semlanik/eScooterControl/eScooterNextGen.png

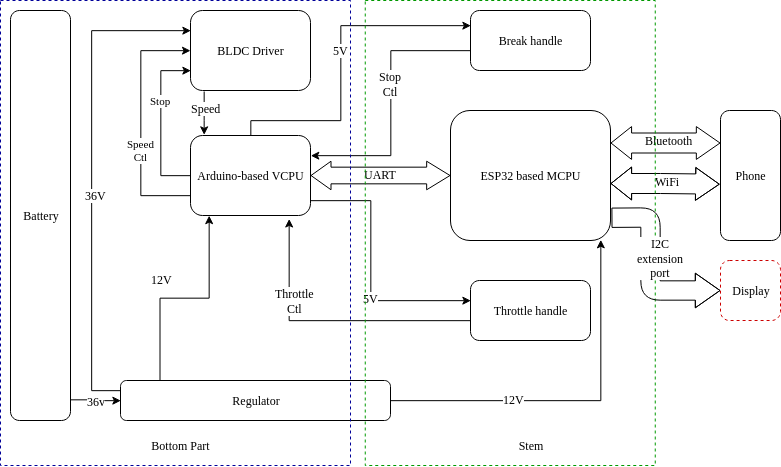
eScooterNextGen.png
