semlanik/eScooterControl/schematic/regulator_schematic.pdf

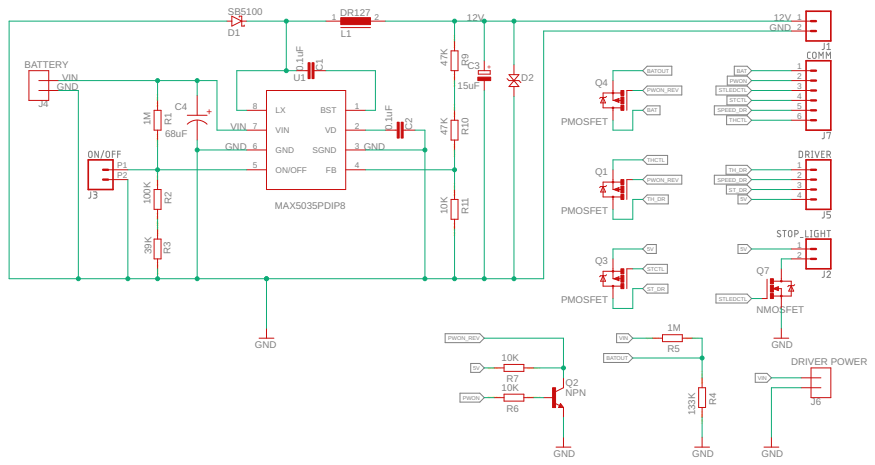
[picture p2: page 1]

SpiceOrder 1 SpiceOrder 2 SpiceOrder 1 SpiceOrder 2 SpiceOrder 1 SpiceOrder 2 SpiceOrder 1 SpiceOrder 2 SpiceOrder 1 SpiceOrder 2 SpiceOrder 1 SpiceOrder 2 SpiceOrder 1 SpiceOrder 2 SpiceOrder 1 SpiceOrder 2 SpiceOrder 1 SpiceOrder 2 SpiceOrder 2 SpiceOrder 1 0.1uF SB5100 DR127 0.1uF 15uF 1M 100K 39K GND 68uF MAX5035PDIP8 BATTERY DRIVER POWER 47K 47K 10K PMOSFET PMOSFET NMOSFET NPN 10K 10K PMOSFET GND GND GND 133K 1M GND C1 D1 1 2 L1 C2 C3 R1 R2 R3 P1P2 121234 D2 C4 BST 1 VD 2 SGND 3 FB 4 ON/OFF 5 GND 6 VIN 7 LX 8 U1 J4 J6 R9 R10 R11 12123456 Q1 Q3 Q7 Q2 R6 R7 Q4 R4 R5 12V 12V THCTL THCTL ST_DR ST_DR 5V 5V 5V 5V STLEDCTL STLEDCTL PWON PWON BAT BAT STCTL STCTL VIN VIN VIN VIN GND GND GND GND BATOUT BATOUT SPEED_DR SPEED_DR TH_DR TH_DR PWON_REV PWON_REV PWON_REV + +
