semlanik/eScooterControl/schematic/ECU_schematic.pdf

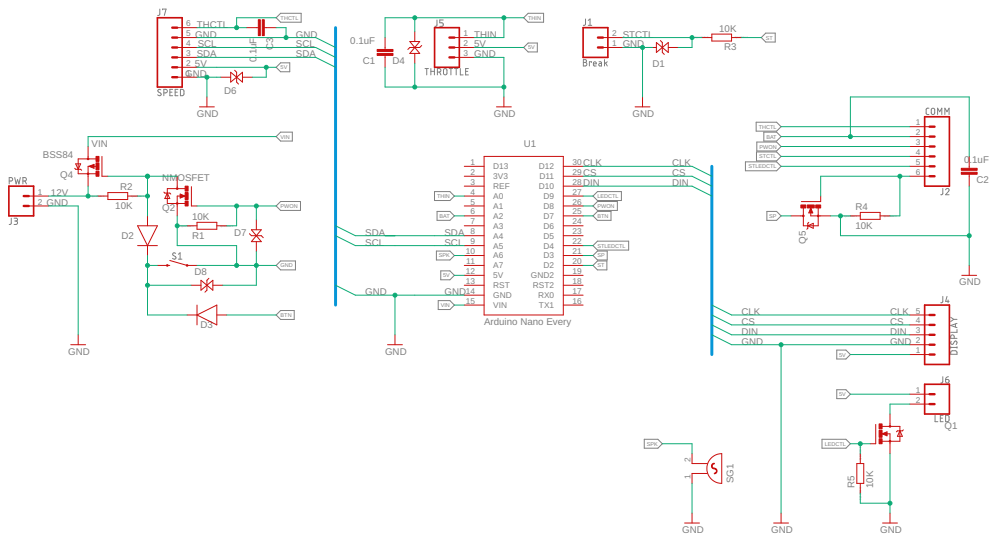
[picture p3: page 1]
