semlanik/eScooterControl/schematic/regulator.brd

## EAGLE design schematic/regulator.brd (2020-10-26)

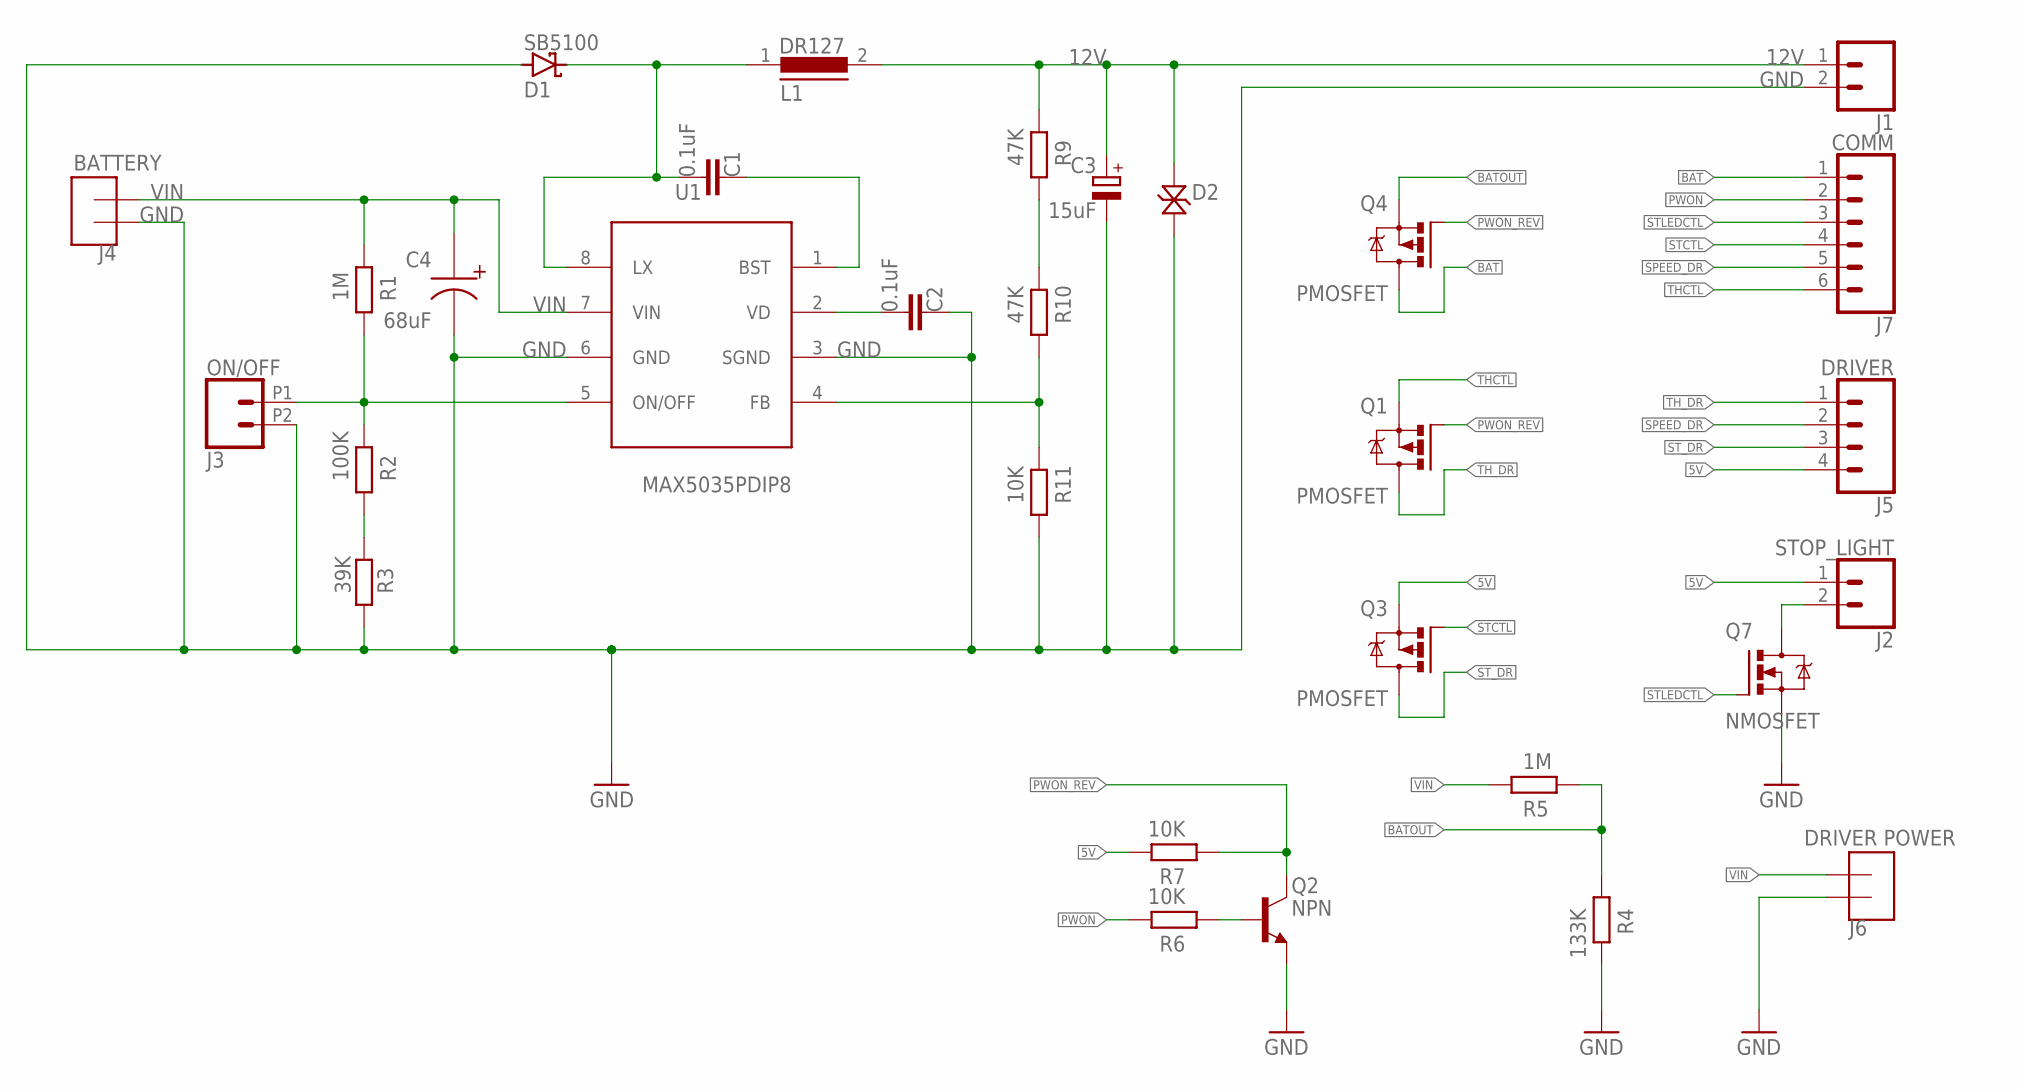
[picture p4: schematic regulator.sch]

Parts:
C1, C2: 0.1uF; CAPC3216X135
C3: 15uF; CAPMP7343X310N
C4: 68uF; CAPAE1230X1250N
D1: SB5100; DO201AD
D2: P4SMAJ12CA; DIOM5027X220N
J1: CONN_02PTH3; 1X02_LONGPADS
J2: STOP_LIGHT; 1X02
J3: ON/OFF; 1X02_2.54_SCREWTERM
J4: BATTERY; XT60
J5: DRIVER; 1X04
J6: DRIVER POWER; XT60
J7: COMM; 1X06_LONGPADS
L1: DR127
Q1, Q3, Q4: PMOSFET; SOT23
Q2: NPN; SOT95P237X112-3N
Q7: NMOSFET; SOT23
R1, R5: 1M; R1206
R2: 100K; R1206
R3: 39K; R1206
R4: 133K; R1206
R6, R7, R11: 10K; R1206
R9, R10: 47K; R1206
U1: MAX5035PDIP8; DIP826W56P254L937H458Q8B

Connections:
5V: J2.1, J5.4, Q3.2 (S), R7.1
12V: C3.1 (+), D2.1, J1.1, L1.2, R9.1
BAT: J7.1, Q4.3 (D)
BATOUT: Q4.2 (S), R4.2, R5.1
GND: C2.1, C3.2 (-), C4.2, D1.A, D2.2, J1.2, J3.P2 (2), J4.GND, J6.GND, Q2.1 (E), Q7.2 (S), R3.1, R4.1, R11.2, U1.3 (SGND), U1.6 (GND)
unnamed: C1.1, U1.1 (BST)
unnamed: C1.2, D1.C, L1.1, U1.8 (LX)
unnamed: Q2.2 (B), R6.2
unnamed: C2.2, U1.2 (VD)
unnamed: J3.P1 (1), R1.2, R2.1, U1.5 (ON/OFF)
unnamed: R9.2, R10.1
unnamed: R2.2, R3.2
unnamed: R10.2, R11.1, U1.4 (FB)
PWON: J7.2, R6.1
PWON_REV: Q1.1 (G), Q2.3 (C), Q4.1 (G), R7.2
SPEED_DR: J5.2, J7.5
STCTL: J7.4, Q3.1 (G)
STLEDCTL: J7.3, Q7.1 (G)
STLEDOUT: J2.2, Q7.3 (D)
ST_DR: J5.3, Q3.3 (D)
THCTL: J7.6, Q1.2 (S)
TH_DR: J5.1, Q1.3 (D)
VIN: C4.1, J4.VCC, J6.VCC, R1.1, R5.2, U1.7 (VIN)

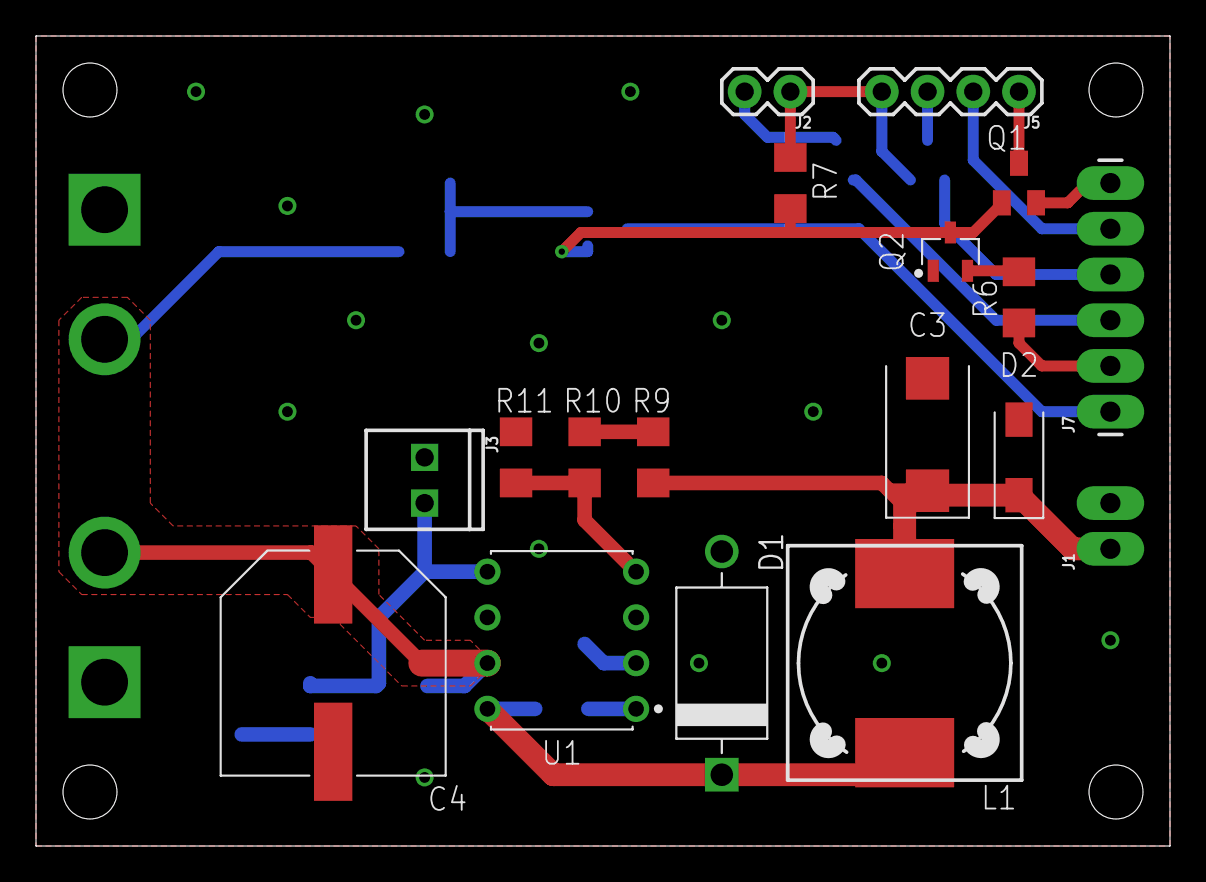
[picture p5: board regulator.brd from above]

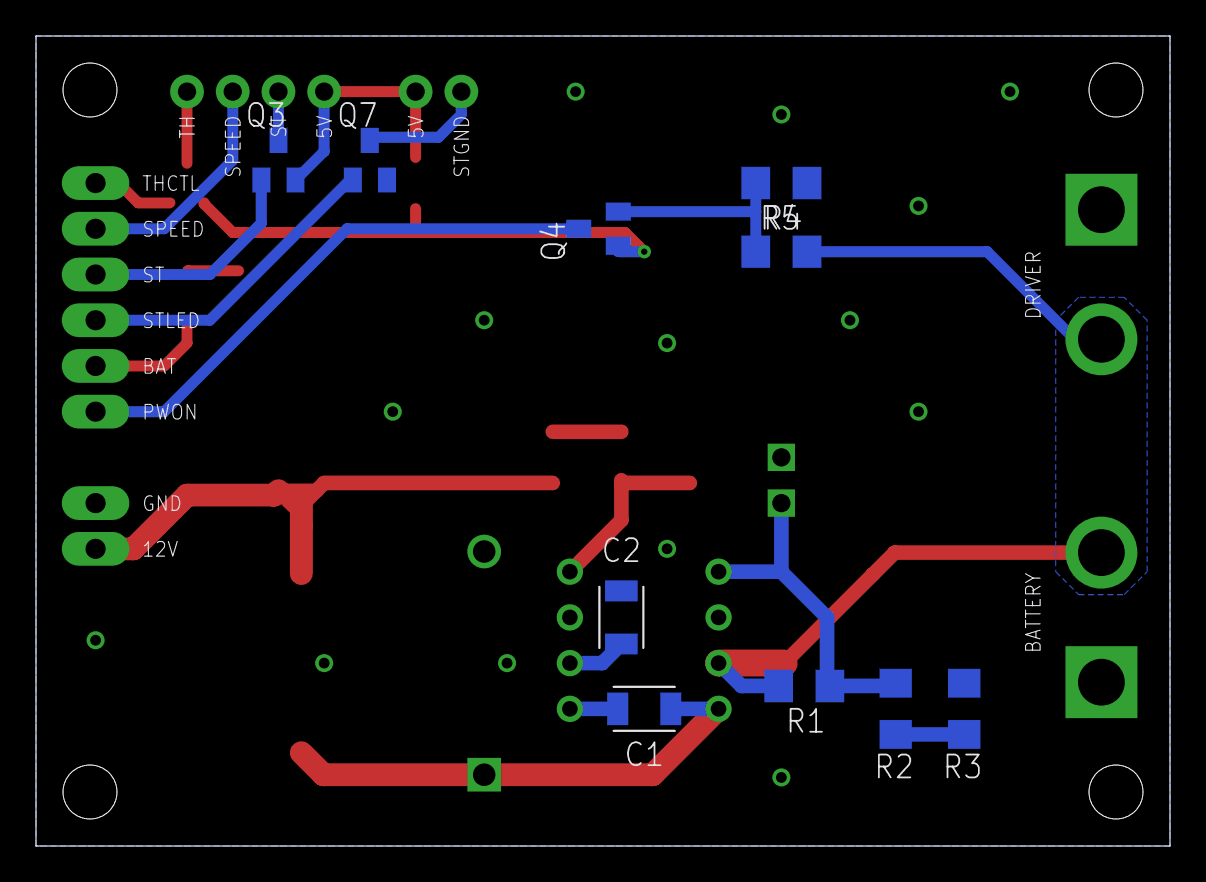
[picture p6: board regulator.brd from below]

Board: 2 copper layers, 63.0 x 45.0 mm, 30 parts (10 on the bottom side), 23 nets.
