semlanik/eScooterControl/schematic/ECU.brd

## EAGLE design schematic/ECU.brd (2020-10-22)

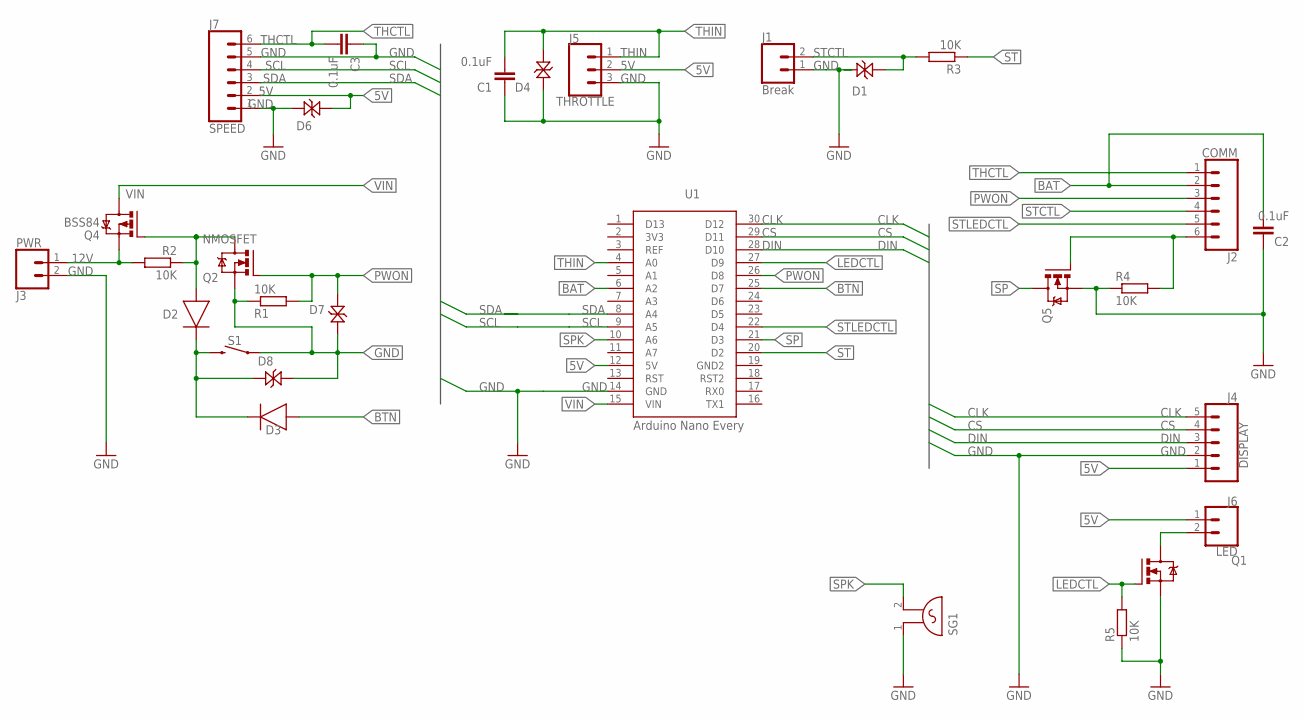
[picture p7: schematic ECU.sch]

Parts:
C1, C2, C3: 0.1uF; CAPC3216X135
D1, D4, D6, D7, D8: TVS_DIODESMA; DIOM5027X220N
D2, D3: DIODE_DO-215-AC; SOD6126X290
J1: Break; 1X02
J2: COMM; 1X06
J3: PWR; 1X02
J4: DISPLAY; 1X05
J5: THROTTLE; 1X03
J6: LED; 1X02
J7: SPEED; 1X06
Q1, Q2, Q5: NMOSFET; SOT23
Q4: BSS84; SOT23
R1, R2, R3, R4, R5: 10K; R1206
S1: MOMENTARY-SWITCH-SPST-PTH-6.0MM; TACTILE_SWITCH_PTH_6.0MM
SG1: F/HGP
U1: Arduino Nano Every; SON254P1750X4300X120-30M

Connections:
3V3: U1.2 (3V3)
5V: D6.1, J4.1, J5.2, J6.1, J7.2, U1.12 (5V)
12V: J3.1, Q4.2 (S), R2.2
BAT: C2.1, J2.2, U1.6 (A2)
BTN: D3.2 (A), U1.25 (D7)
CLK: J4.5, U1.30 (D12)
CS: J4.4, U1.29 (D11)
DIN: J4.3, U1.28 (D10)
GND: C1.1, C2.2, C3.2, D1.1, D4.1, D6.2, D7.2, D8.1, J1.1, J3.2, J4.2, J5.3, J7.1, J7.5, Q1.2 (S), Q2.2 (S), Q5.2 (S), R1.1, R4.1, R5.1, S1.1, S1.2 (1), SG1.1, U1.14 (GND)
GND2: U1.19 (GND2)
LEDCTL: Q1.1 (G), R5.2, U1.27 (D9)
unnamed: J6.2, Q1.3 (D)
unnamed: D2.2 (A), Q2.3 (D), Q4.1 (G), R2.1
unnamed: D2.1 (C), D3.1 (C), D8.2, S1.3 (2), S1.4 (2)
PWON: D7.1, J2.3, Q2.1 (G), R1.2, U1.26 (D8)
SCL: J7.4, U1.9 (A5)
SDA: J7.3, U1.8 (A4)
SP: Q5.3 (D), U1.21 (D3)
SPEED: J2.6, Q5.1 (G), R4.2
SPK: SG1.2, U1.10 (A6)
ST: R3.1, U1.20 (D2)
STCTL: D1.2, J1.2, J2.4, R3.2
STLEDCTL: J2.5, U1.22 (D4)
THCTL: C3.1, J2.1, J7.6
THIN: C1.2, D4.2, J5.1, U1.4 (A0)
VIN: Q4.3 (D), U1.15 (VIN)

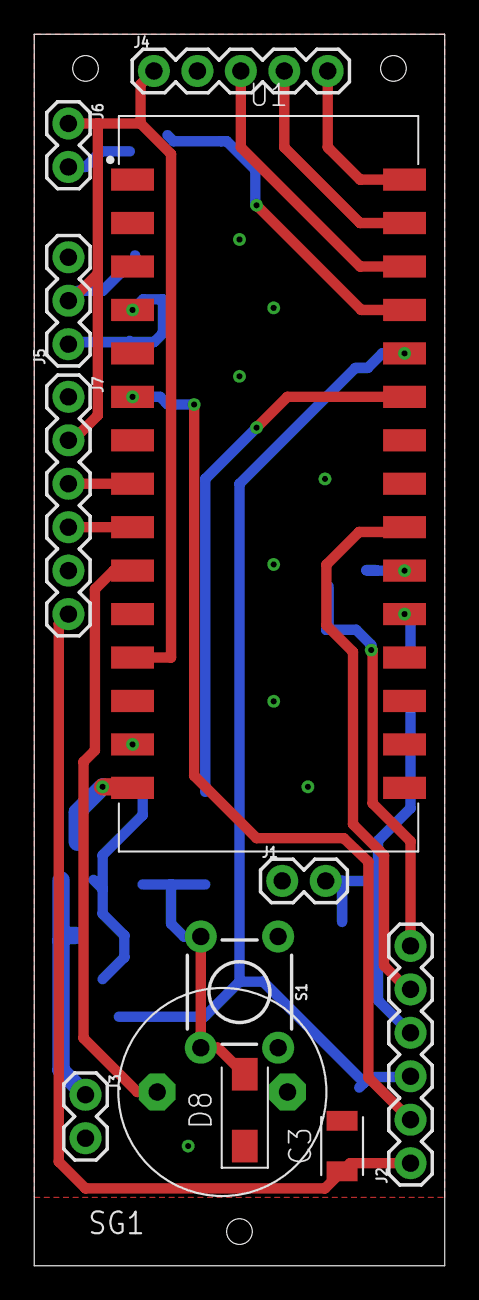
[picture p8: board ECU.brd from above]

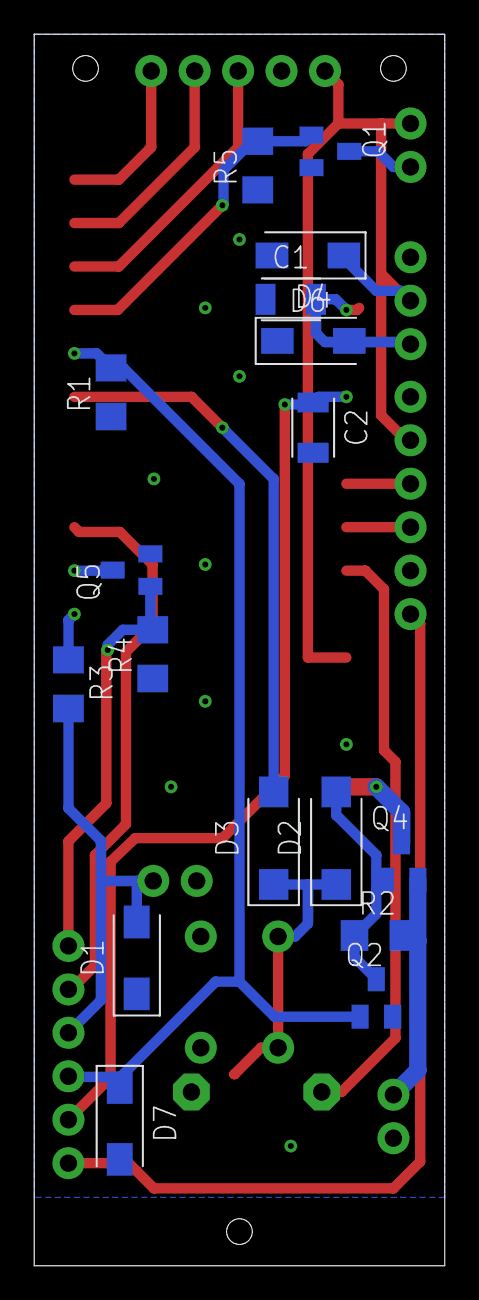
[picture p9: board ECU.brd from below]

Board: 2 copper layers, 24.0 x 72.0 mm, 29 parts (17 on the bottom side), 24 nets.
