semlanik/eScooterControl/(threads)

Thread 1 (2020-10-18):

Знаки общих проводов и линий питания

vxm9, 2020-10-18:
Глянул ECU_schematic
Настоятельно рекомендую убрать со схемы путаницу из проводников питания, особенно GND. C 5V же получилось. При трассировке программа все равно потребует соединить, а на схеме они только мешаются.
https://cxem.net/beginner/beginner134.php
Даже если просто убрать со схемы земляные провода - она уже будет проще читаться.
Кроме того, для того, чтобы схему было логичнее читать - ее делают слева направо и сверху вниз, похоже на нотацию IDEF0.
Слева - вход всяких напряжений питания, справа - выход.
Сверху - вход управляющих воздействий, кнопок, потенциометров. Снизу - управляемые устройства (например, в вашем случае - дисплей).

semlanik, 2020-10-20:
Приветсвую, спасибо за комментарии. Я немного переделал схематику, после первых тестов. Попробую привести в порядок. В целом если будет желание/время будет круто если будут предложения по функциональной части схематик. Спасибо!
