semlanik/eScooterControl/Arduino/eScooterControl/eScooterControl.ino

/*
 * MIT License
 *
 * Copyright (c) 2020 Alexey Edelev <semlanik@gmail.com>
 *
 * This file is part of eScooterControl project https://github.com/semlanik/eScooterControl
 *
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
 * THE SOFTWARE IS PROVIDED "AS IS", WITHOUT WARRANTY OF ANY KIND, EXPRESS OR IMPLIED,
 * INCLUDING BUT NOT LIMITED TO THE WARRANTIES OF MERCHANTABILITY, FITNESS FOR A PARTICULAR
 * PURPOSE AND NONINFRINGEMENT. IN NO EVENT SHALL THE AUTHORS OR COPYRIGHT HOLDERS BE LIABLE
 * FOR ANY CLAIM, DAMAGES OR OTHER LIABILITY, WHETHER IN AN ACTION OF CONTRACT, TORT OR
 * OTHERWISE, ARISING FROM, OUT OF OR IN CONNECTION WITH THE SOFTWARE OR THE USE OR OTHER
 * DEALINGS IN THE SOFTWARE.
 */
#include "thread.h"
#include "display.h"
#include "speedometer.h"
#include "accelerationcontrol.h"
#include "buttoncontrol.h"
#include "battery.h"

const unsigned long AcceleratorPedalUpdateTime = 200;
const unsigned long AcceleratorUpdateTime = 10;
const unsigned long DisplayUpdateTime = 250;
const unsigned long BatteryUpdateTime = 1000;
const unsigned long ButtonHandlingTime = 50;

Thread gDisplayThread = Thread(DisplayUpdateTime);
Thread gBatteryThread = Thread(BatteryUpdateTime);
Thread gAcceleratorPedalThread = Thread(AcceleratorPedalUpdateTime);
Thread gAcceleratorThread = Thread(AcceleratorUpdateTime);
Thread gButtonThread = Thread(ButtonHandlingTime);

unsigned char fakeBatteryLevel = 0;

void setup() {
//  Serial.begin(115200);
//  Serial.println("Init");

  ButtonControl::instance();
  gButtonThread.assignCallback([](){
    ButtonControl::instance()->dispatch();
  });

  delay(500);
  Display::instance();
  gDisplayThread.assignCallback([](){
    Display::instance()->updateDisplayBuffer();
  });

  delay(1000);
  AccelerationControl::instance();
  gAcceleratorPedalThread.assignCallback([](){
    AccelerationControl::instance()->dispatch();
  });

  gAcceleratorThread.assignCallback([](){
    AccelerationControl::instance()->dispatchAcceleration();
  });

  delay(500);
  Speedometer::instance();

  gBatteryThread.assignCallback([](){
    BatterySensor::instance()->dispatch();
  });

  digitalWrite(PowerPin, HIGH); //Initialization end

//  Serial.println("Init complete");
}

void loop() {
  Thread::dispatch();
}
