semlanik/eScooterControl/Arduino/eScooterControl/accelerationcontrol.cpp

/*
 * MIT License
 *
 * Copyright (c) 2020 Alexey Edelev <semlanik@gmail.com>
 *
 * This file is part of eScooterControl project https://github.com/semlanik/eScooterControl
 *
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
 * THE SOFTWARE IS PROVIDED "AS IS", WITHOUT WARRANTY OF ANY KIND, EXPRESS OR IMPLIED,
 * INCLUDING BUT NOT LIMITED TO THE WARRANTIES OF MERCHANTABILITY, FITNESS FOR A PARTICULAR
 * PURPOSE AND NONINFRINGEMENT. IN NO EVENT SHALL THE AUTHORS OR COPYRIGHT HOLDERS BE LIABLE
 * FOR ANY CLAIM, DAMAGES OR OTHER LIABILITY, WHETHER IN AN ACTION OF CONTRACT, TORT OR
 * OTHERWISE, ARISING FROM, OUT OF OR IN CONNECTION WITH THE SOFTWARE OR THE USE OR OTHER
 * DEALINGS IN THE SOFTWARE.
 */
#include "singleton.h"
#include "accelerationcontrol.h"
#include "pinconfig.h"
#include "Wire.h"
#include "display.h"

#include <avr/pgmspace.h>

const int AcceleratorSensorStep = 10;
const int AcceleratorStep = 21;//From 0 to 4095 for 2s with update each 10ms
const int MaxLevel = 10;

const PROGMEM unsigned short AccelerationLevelTable[11] = {
  0,
  410,
  820,
  1230,
  1640,
  2050,
  2460,
  2870,
  3280,
  3690,
  4095
};


AccelerationControl::AccelerationControl() : m_stopState(LOW)
  , m_acceleratorMinValue(0)
  , m_accelerationLevel(0)
  , m_expectedAcceleration(0)
  , m_actualAcceleration(0)
  , m_cruiseTime(0)
  , m_cruiseLevel(0)
{
  Wire.begin();
  pinMode(AcceleratorSensorPin, INPUT);
  pinMode(StopSensorPin, INPUT_PULLUP);
  attachInterrupt(digitalPinToInterrupt(StopSensorPin), []() {
    AccelerationControl::instance()->stop();
  }, CHANGE);

  m_stopState = digitalRead(StopSensorPin);
  m_acceleratorMinValue = analogRead(AcceleratorSensorPin);
}


void AccelerationControl::setAccelerationLevel(const byte level)
{
  if (level == m_accelerationLevel) {
    if (m_cruiseLevel < m_accelerationLevel
          && m_cruiseTime < millis()) {
      m_cruiseLevel = m_accelerationLevel;
    }
    return;
  }

  if (level > m_accelerationLevel) {
    m_cruiseLevel = 0; //Reset cruise whenever accelerator level raised, when drop it means we go down
    m_cruiseTime = millis() + CruiseTime;  
  }

  m_accelerationLevel = level;
}

void AccelerationControl::dispatch()
{  
  if (m_stopState == LOW) {
    setAccelerationLevel(readAcceleratorData());
  }
  updateAcceleration();
}

void AccelerationControl::stop() {
  m_stopState = digitalRead(StopSensorPin);
  Display::instance()->setStop(m_stopState == LOW);
  if (m_stopState == LOW) {
    m_cruiseLevel = 0; //reset cruise when stop
    setAccelerationLevel(0);
  }
}

byte AccelerationControl::readAcceleratorData()
{
  unsigned int value = analogRead(AcceleratorSensorPin);
  if (value < m_acceleratorMinValue) {
    m_acceleratorMinValue = value; //Andjust min value accordingly
  }
//  Serial.print("Accelerator sensor: ");
//  Serial.print(value);
//  Serial.print(" ");
  byte outValue = round(MaxLevel * float(value - m_acceleratorMinValue) / AcceleratorSensorDiff);
  if (outValue > MaxLevel) {
    outValue = MaxLevel;
  }
//  Serial.println(outValue);
  return outValue;
}

void AccelerationControl::updateAcceleration() {
//  Serial.print("Acceleration level: ");
//  Serial.println(m_accelerationLevel);

  byte level = m_accelerationLevel;
  if (m_cruiseLevel > 0) {//At cruise control
    level = m_cruiseLevel;
  }

  Display::instance()->setAcceleration(level);

  m_expectedAcceleration = pgm_read_word(&AccelerationLevelTable[level]);
//  Serial.print("Expected acceleration: ");
//  Serial.println(m_expectedAcceleration);
}

void AccelerationControl::dispatchAcceleration()
{
  if (m_actualAcceleration == m_expectedAcceleration) {
    return;
  }
  
  if (m_actualAcceleration > m_expectedAcceleration) {
    //No need to step down, set acceleration immediatelly
    m_actualAcceleration = m_expectedAcceleration;
  } else if (m_actualAcceleration < m_expectedAcceleration) {
    m_actualAcceleration += AcceleratorStep;
    if (m_actualAcceleration > 0x0fff) {
      m_actualAcceleration = 0x0fff;
    }
  }

  Wire.beginTransmission(AcceleratorAddress);
  Wire.write(0x40);
  Wire.write(m_actualAcceleration >> 4);
  Wire.write((m_actualAcceleration & 15) << 4);
  Wire.endTransmission();

//  float expectedVoltage = 5.0f / 0x0fff * float(m_actualAcceleration);
//  Serial.print("Expected voltage: ");
//  Serial.println(expectedVoltage);
}
