semlanik/eScooterControl/(commit log)

2020-04-02 Inital version
    - Display speed based on hall sensor
    - Display fake battery level
2020-06-09 Implement basic speed control
    - Add speed pedal status read
    - Add cruise control
    - Add break logic
    - Add extra display support and switch speed display position
2020-07-08 Implement speed control
    - Current version of Adafruit MCP4725 library hangs at begin()
    It's either software or hardware issue. Need to migrate to pure
    Wire and check where is issue.
    [accelerationcontrol.cpp, accelerationcontrol.h, eScooterControl.ino, pinconfig.h]
2020-07-09 Migrate to direct wire usage for acceleration control
    - Add initialization delays, to supress intial voltage jumps effect
    for peripheral devices
    - Replace adafruit MCP library with pure Wire. Transmission without
    data at setup() phase breaks application.
    [accelerationcontrol.cpp, accelerationcontrol.h, eScooterControl.ino, pinconfig.h]
2020-07-09 Add acceleration level display
    - Enable second display
    - Add acceleration level display on second display
    - Fix moment speed calculation, add pulse per cicle divider for
    speed pulse sensor.
    [accelerationcontrol.cpp, display.cpp, display.h, eScooterControl.ino, pinconfig.h, speedometer.cpp]
2020-07-11 Implement button handling
    - Add power button handling
    - Add led switch logic
    - Code cleanup
2020-07-13 Code optimization
    - Remove excess millis usage
    - Remove thread dispatch time
    - Replace 'unsigned char' type by 'byte'
    - Optimize drawing
    - Replace 'int' by 'bool' for pin states
    - Align types usage
    [accelerationcontrol.cpp, accelerationcontrol.h, buttoncontrol.cpp, buttoncontrol.h, display.cpp, display.h, eScooterControl.ino, pinconfig.h]
2020-07-13 Add new display features
    - Optimize display update
    - Add light, eco and stop signs
    - Rework display of battery level
    - Move acceleration level up
    [accelerationcontrol.cpp, buttoncontrol.cpp, display.cpp, display.h, eScooterControl.ino]
2020-07-15 Fix power logic
    - Make default state of PWR pin to 1
    - Change power timings
    [buttoncontrol.cpp, eScooterControl.ino]
2020-07-15 Remove useless attachToDisplay
2020-07-17 Add Eagle CAD schematics
    - Add Eagle CAD schematics for regulator and control parts
    [ECU.brd, ECU.sch, regulator.brd, regulator.sch]
2020-07-17 Align pin configuration to schematics
2020-07-17 Fix stop sensor schematics
    - Make stop sensor LOW by default, connected to GND.
    - Add control transistor for break on BLDC
    [ECU.brd, ECU.sch]
2020-07-17 Align stop pin behavior
    - Make stop pin pure input without pullup
    - Inverse stop pin logic, HIGH level is active break
2020-07-17 Fix minor issues in schematics
    - Fix issues with non-connected ground on PCB for speed mosfet
    - Add pdf and gerber files for control unit schematics
    [ECU.brd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]
2020-07-17 Add regulator schematic pdf
2020-07-18 Update schematics
    - Add TVS diodes for ESD protection
    - Add resistors on MOSFET gates
    - Make voltage divider on 2 resistors(4 previously)
    - Align signal names on regulator and ECU schematics
    [ECU.brd, ECU.sch, regulator.brd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]
2020-07-18 Update schematics for regulator
    - Add elements nominals and correct values
    - Fix library inconsistence
    - Few cosmetical changes in schematics
    [ECU.brd, ECU.sch, regulator.brd, regulator.sch]
2020-07-18 Replace buzzer with 7.6mm contacts spacing
    [ECU.brd, ECU.sch]
2020-07-18 Fix minor issues in PCB
    [ECU.brd, regulator.brd]
2020-07-21 Move regulator elements closer to MAX chip
    [regulator.brd]
2020-07-22 Change MAX regulator package
    - Change MAX package to drill-pin
    - Move button to bottom layout
    - Move elements for better work on regulator and ECU
    [ECU.brd, ECU.sch, regulator.brd, regulator.sch]
2020-07-25 Rearrange elements in regulator schematics
    [regulator.brd, regulator.sch]
2020-07-27 Rework regulator PCB
    - Re-arrange elements
    - Add few ground drills
    [regulator.brd]
2020-09-03 Fix regulator schematics
    - Fix regulator schematics, add missed voltage controll resistors
    - Fix deprecated warnings for display
    [ECU.brd, regulator.brd, regulator.sch]
2020-09-11 Add battery level control
2020-09-11 Replace low-side BLDC driver switch by high-side switch
    - Rearrange elements on regulator schematics
    [regulator.brd, regulator.sch]
2020-10-13 Rework ECU board
    - Align sizes
    - Align elements placement on layers
    - Change power traces in regulator
    [ECU.brd, ECU.sch, regulator.brd]
2020-10-15 Remove high-side switch for driver
    - Keep driver alway on for now
    - Add mosfet switched for speed and throttle
    - Align break work
    [ECU.brd, ECU.sch, regulator.brd, regulator.sch]
2020-10-15 Invert stop pin logic according to new schematics
    - Invert stop pin logic to use high-side p-mosfet switch
    - Update TVS diode symbol
    [ECU.brd, ECU.sch]
2020-10-22 Prettify ECU schematic according to #1
    [ECU.brd, ECU.sch]
2020-10-26 Cosmetical updates on schematics
    [ECU.sch, regulator.brd, regulator.sch]
